protongamer/L3REL_RUCHE/pictures/Arduino_Schematic.png

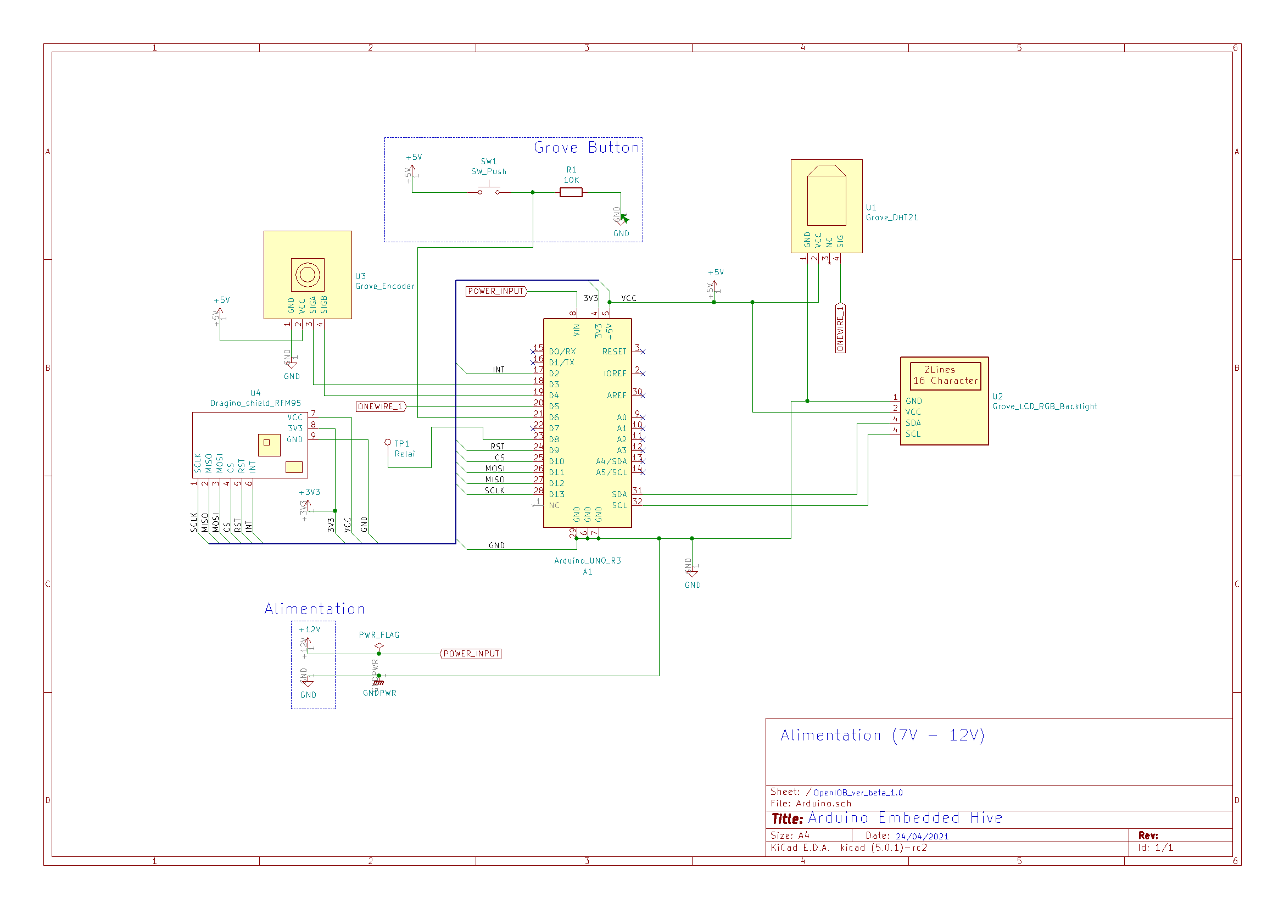
pictures/Arduino_Schematic.png
