protongamer/L3REL_RUCHE/pictures/bouton.png

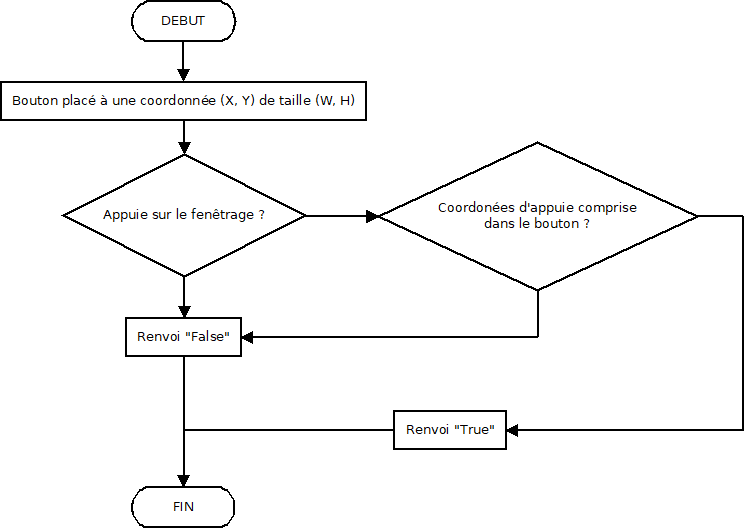
pictures/bouton.png
