protongamer/L3REL_RUCHE/pictures/IMG_20210322_151422.jpg

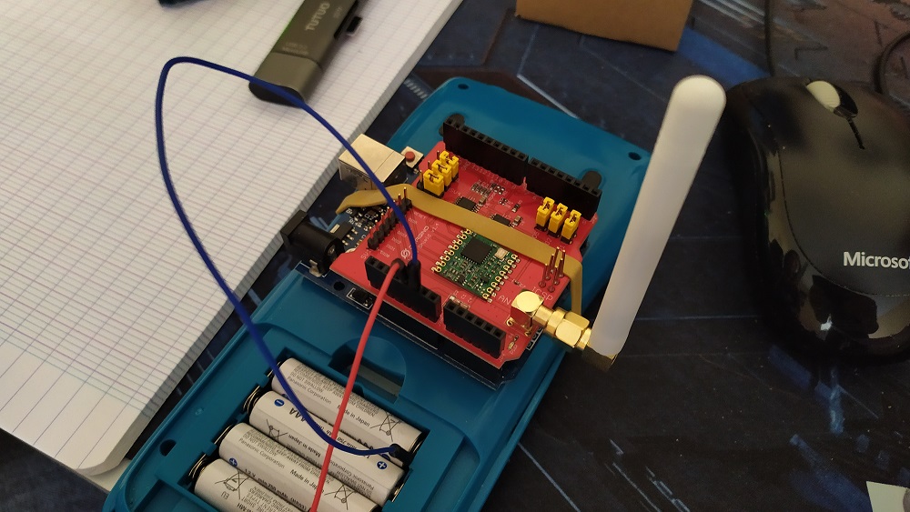
pictures/IMG_20210322_151422.jpg
