protongamer/L3REL_RUCHE/pictures/maps.png

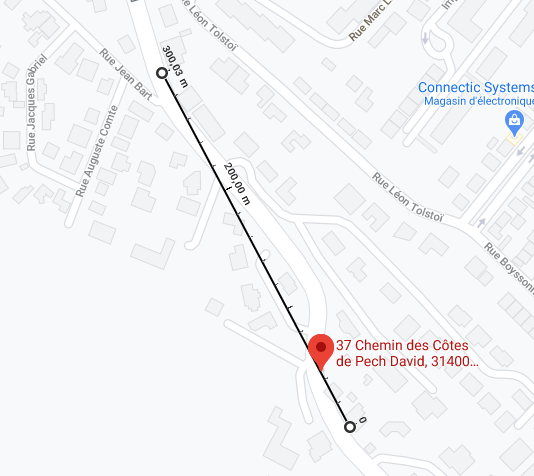
pictures/maps.png
