protongamer/L3REL_RUCHE/pictures/openiob_menus.png

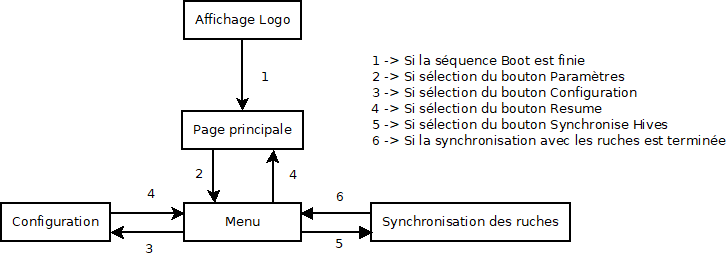
pictures/openiob_menus.png
