protongamer/L3REL_RUCHE/pictures/PSWD.png

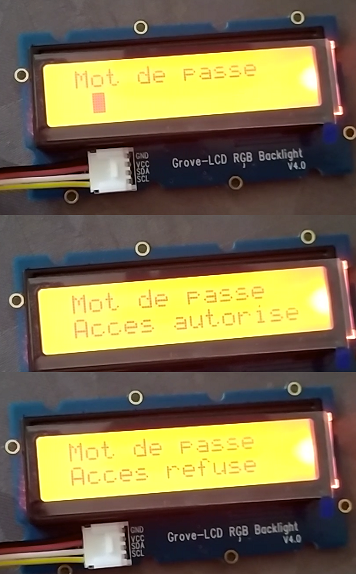
pictures/PSWD.png
