protongamer/L3REL_RUCHE/pictures/RPI_Schematic.png

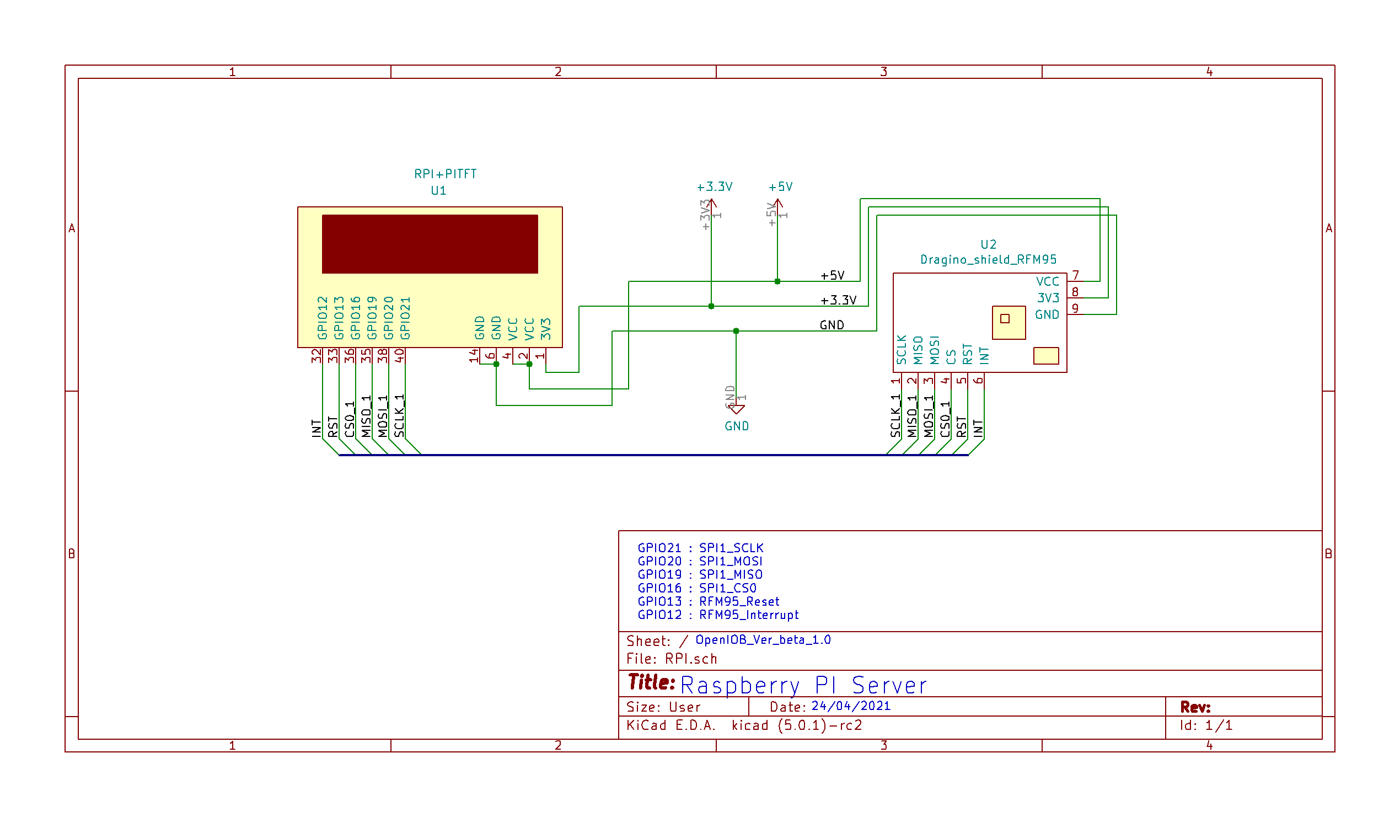
pictures/RPI_Schematic.png
