protongamer/L3REL_RUCHE/pictures/write_database.png

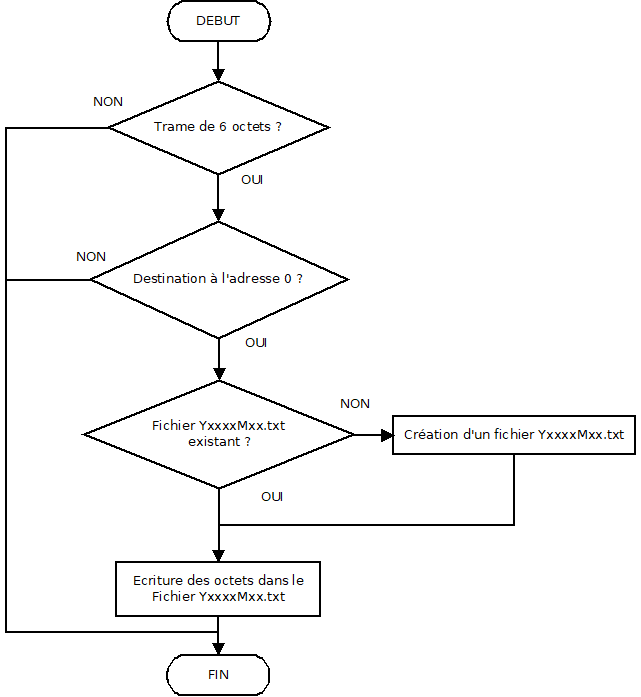
pictures/write_database.png
