protongamer/L3REL_RUCHE/Releves/Tram lu sur Arduino.png

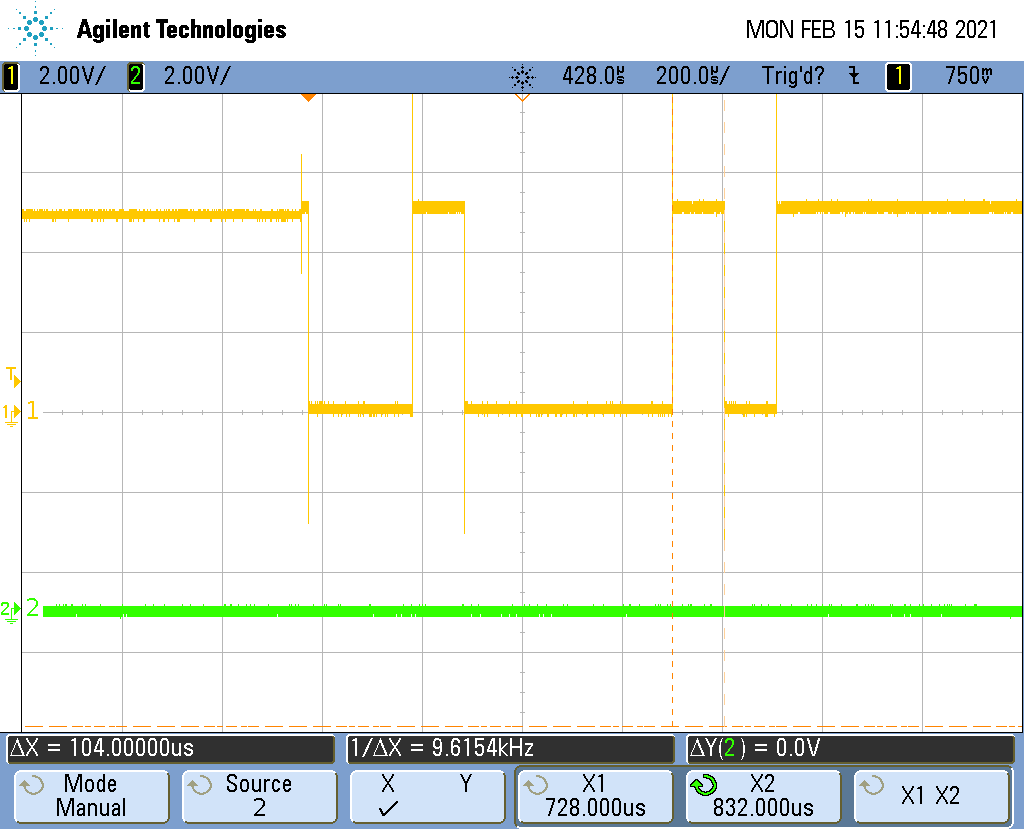
Releves/Tram lu sur Arduino.png
