protongamer/L3REL_RUCHE/Releves/Tram_transmission.PNG

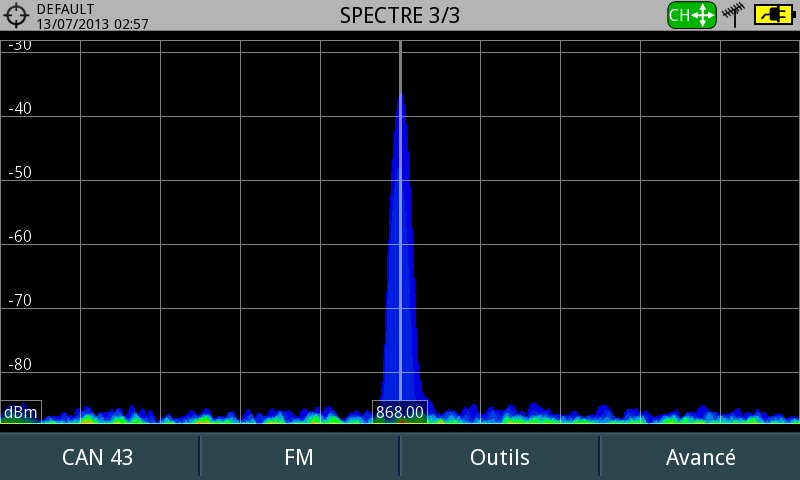
Releves/Tram_transmission.PNG
