protongamer/L3REL_RUCHE/Presentation_Projet.pdf

# Projet Ruche Connectée

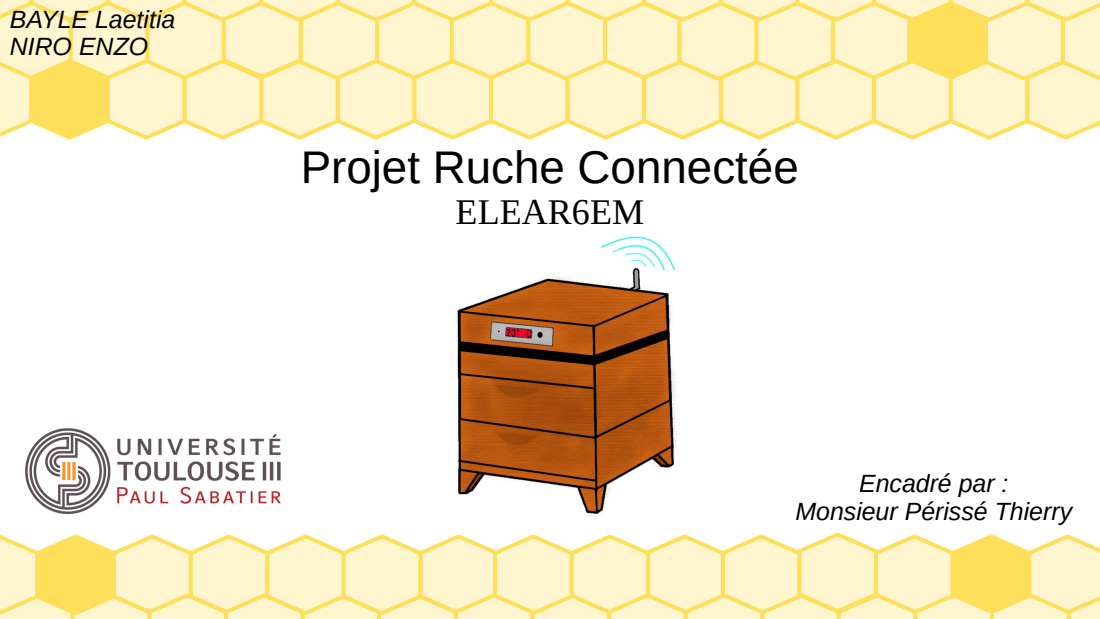
[picture p59: page 1]
ELEAR6EM; BAYLE Laetitia NIRO ENZO

Encadré par :
Monsieur Périssé Thierry

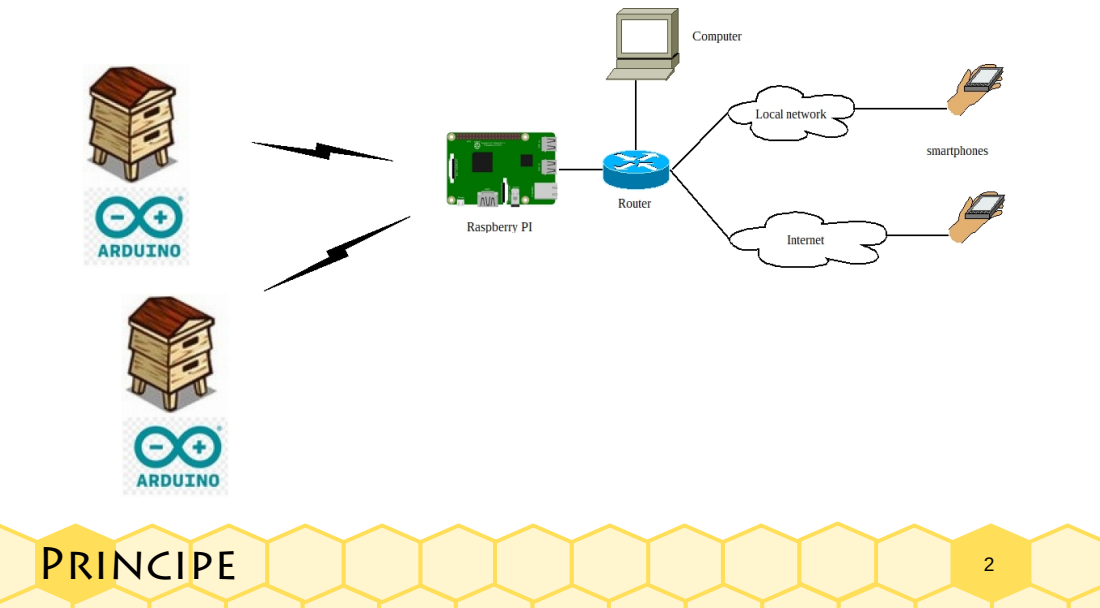
[picture p60: page 2]
Principe

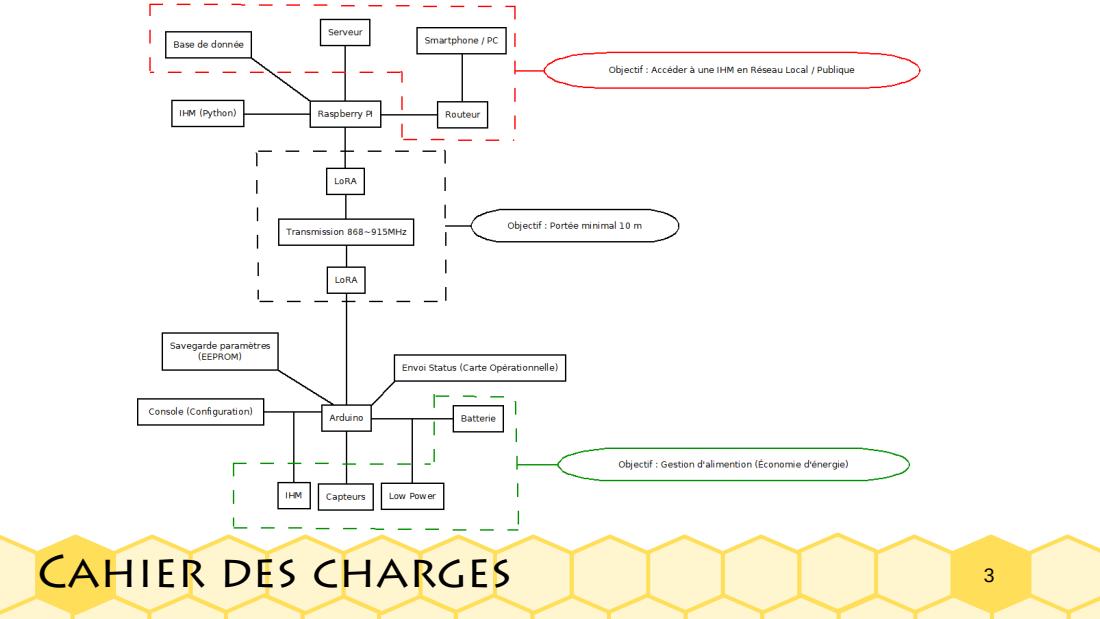
[picture p61: page 3]

Cahier des charges

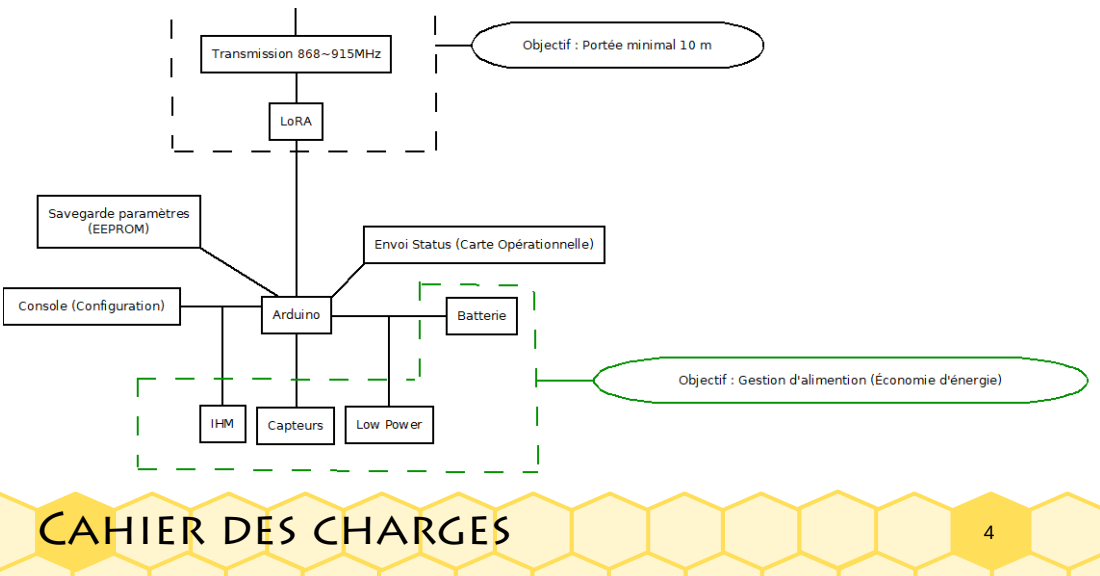
[picture p62: page 4]

Cahier des charges

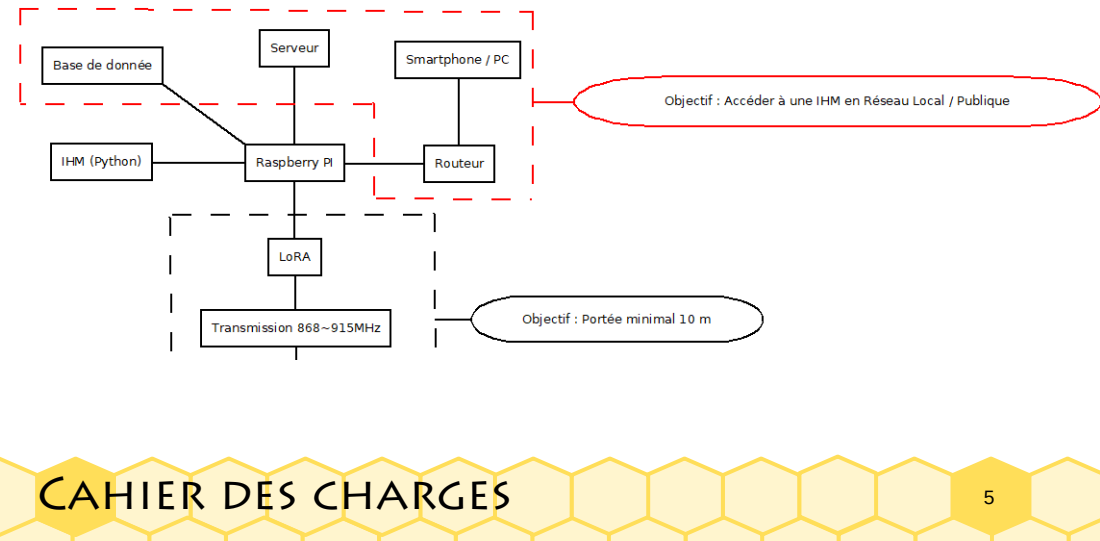
[picture p63: page 5]

Cahier des charges

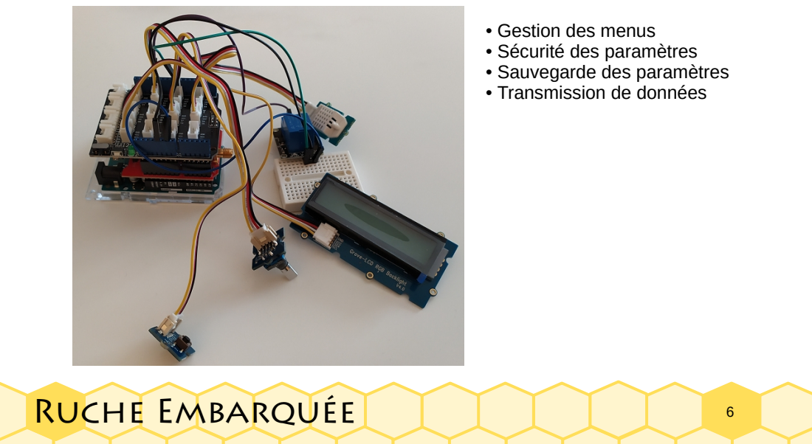
[picture p64: page 6]
Ruche Embarquée

• Gestion des menus
• Sécurité des paramètres
• Sauvegarde des paramètres
• Transmission de données

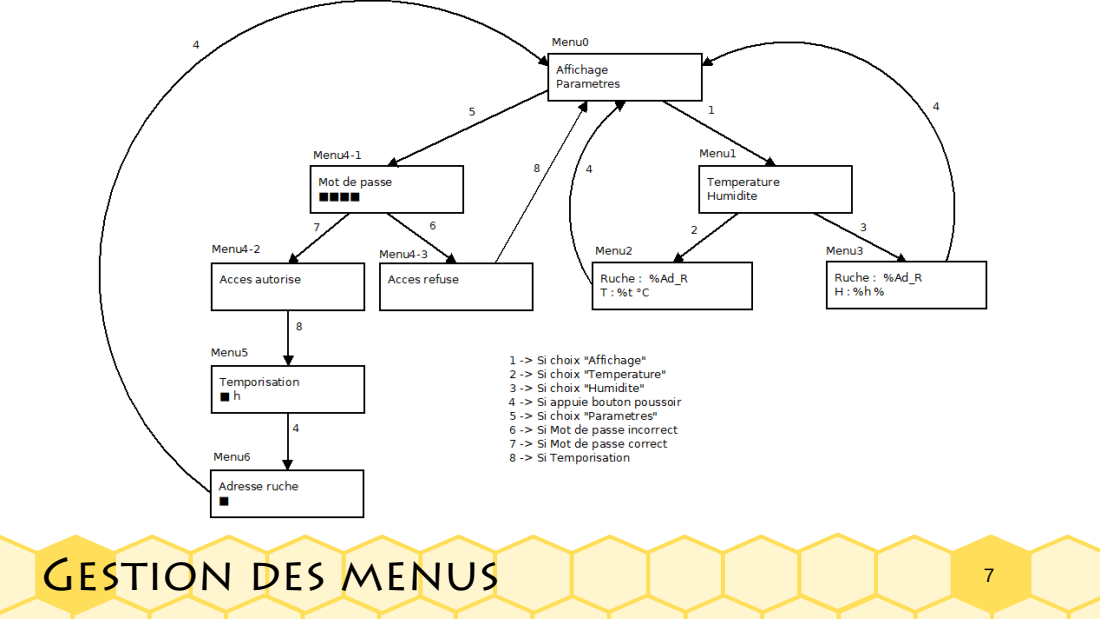
[picture p65: page 7]

Gestion des menus

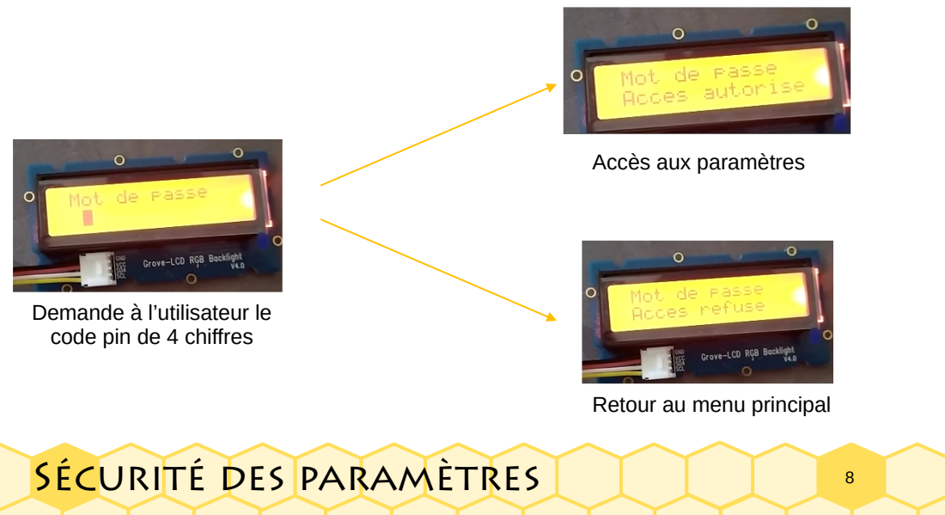
[picture p66: page 8]
Sécurité des paramètres

Accès aux paramètres

Demande à l’utilisateur le
code pin de 4 chiffres

Retour au menu principal

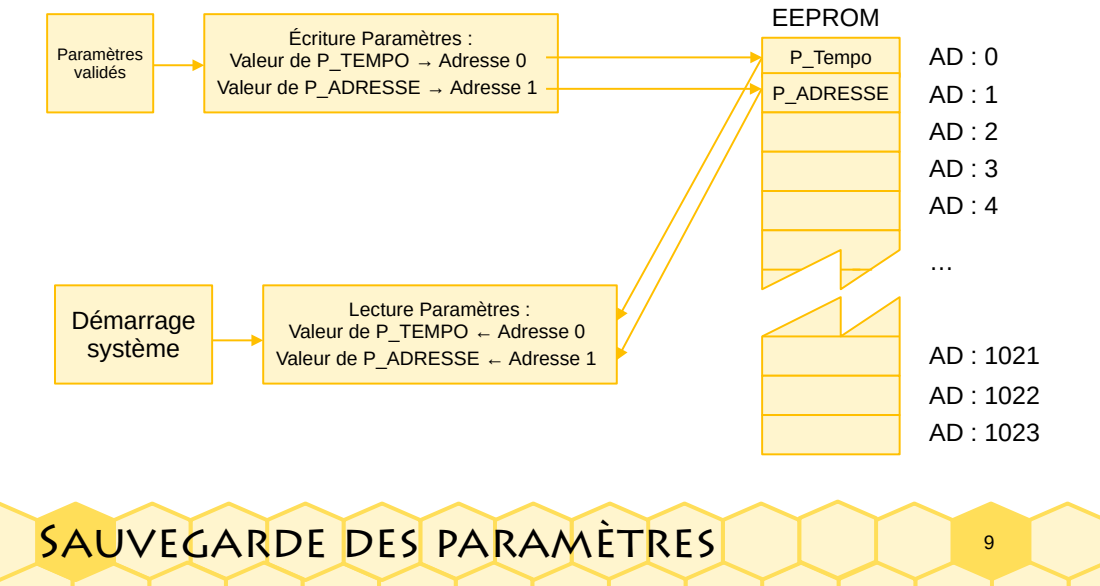
[picture p67: page 9]
Sauvegarde des paramètres; P_Tempo; P_ADRESSE; EEPROM; Paramètres validés; Démarrage système

Écriture Paramètres :
Valeur de P_TEMPO → Adresse 0
Valeur de P_ADRESSE → Adresse 1

Lecture Paramètres :
Valeur de P_TEMPO ← Adresse 0
Valeur de P_ADRESSE ← Adresse 1

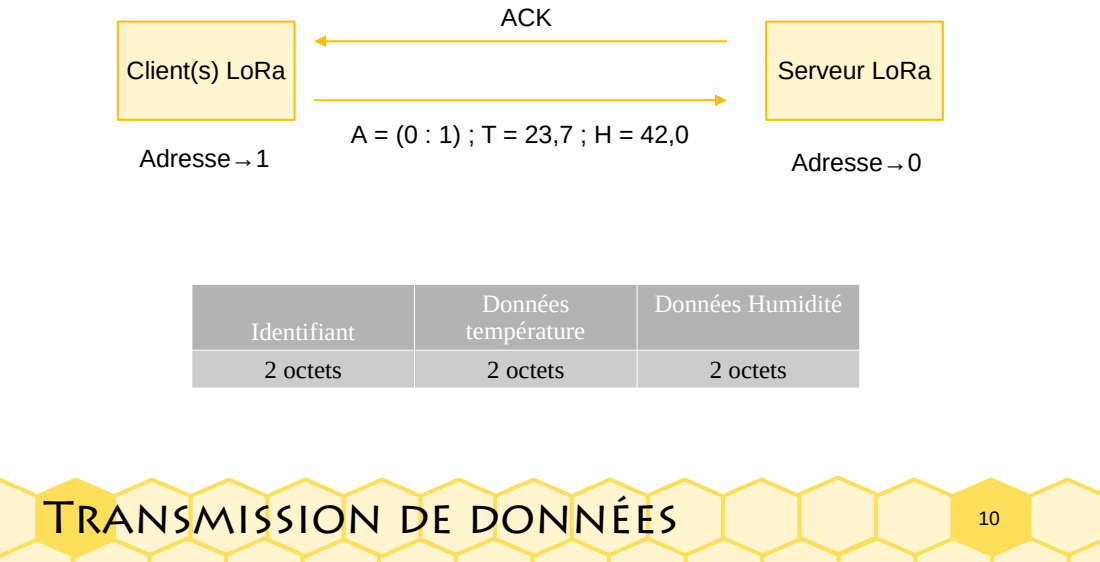
[picture p68: page 10]
Transmission de données; Client(s) LoRa; Serveur LoRa; Adresse→1; Adresse→0; ACK

Identifiant | Données température | Données Humidité

2 octets | 2 octets | 2 octets

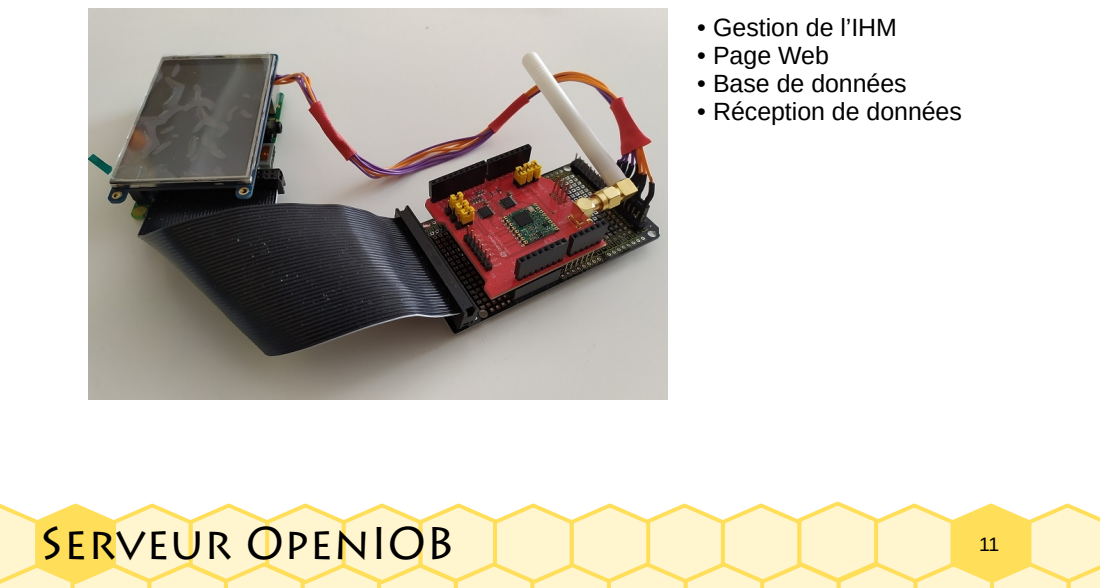
[picture p69: page 11]
Serveur OpenIOB

• Gestion de l’IHM
• Page Web
• Base de données
• Réception de données

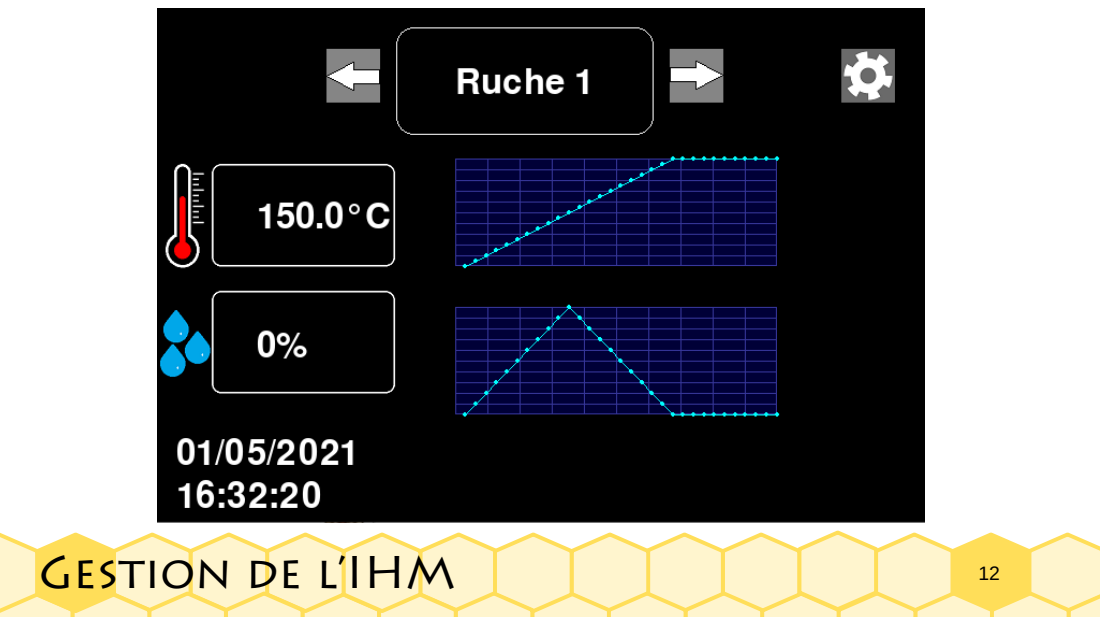
[picture p70: page 12]
Gestion de l’IHM

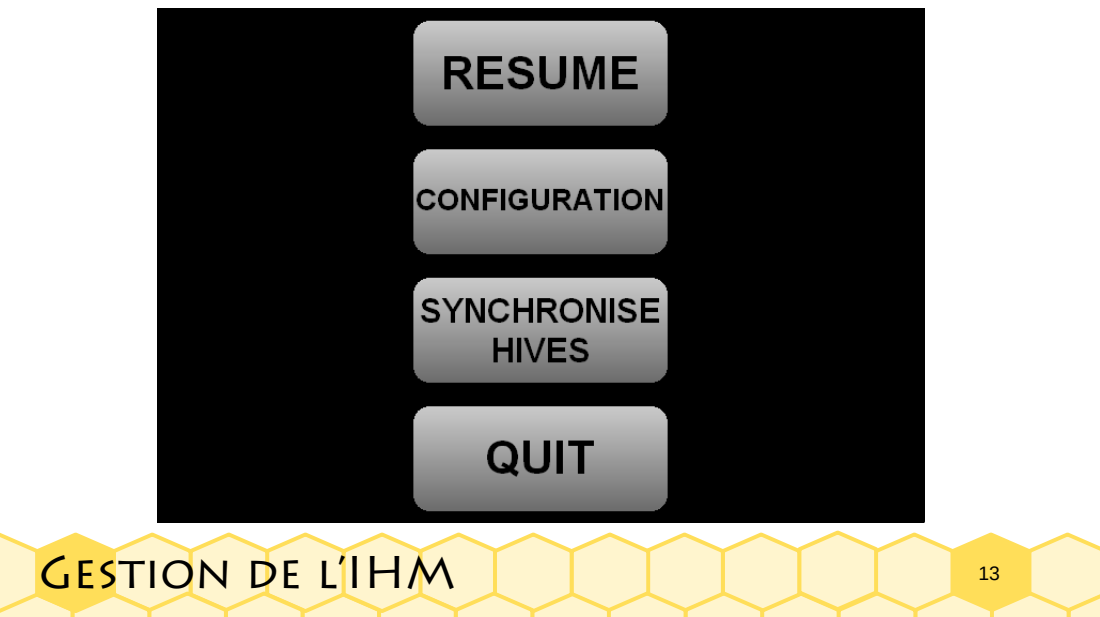
[picture p71: page 13]
Gestion de l’IHM

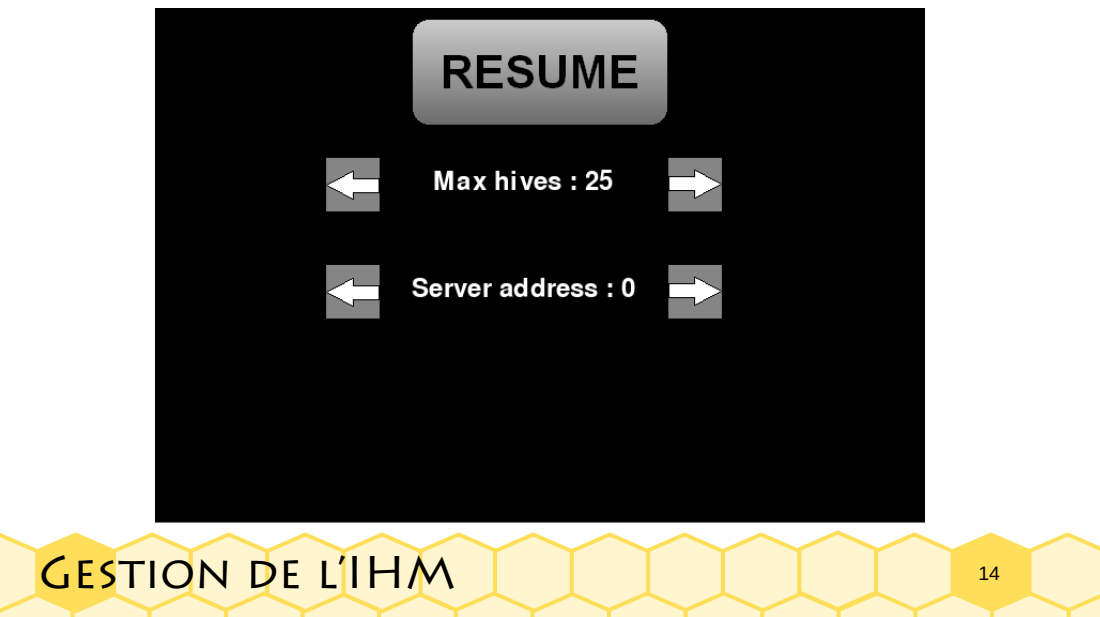
[picture p72: page 14]
Gestion de l’IHM

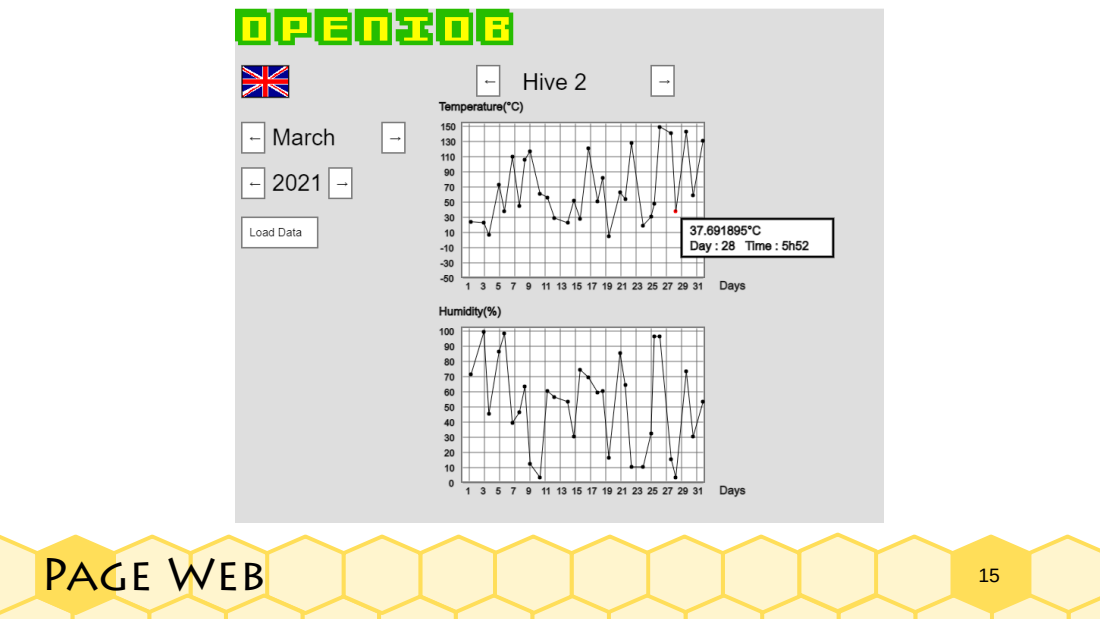
[picture p73: page 15]
Page Web

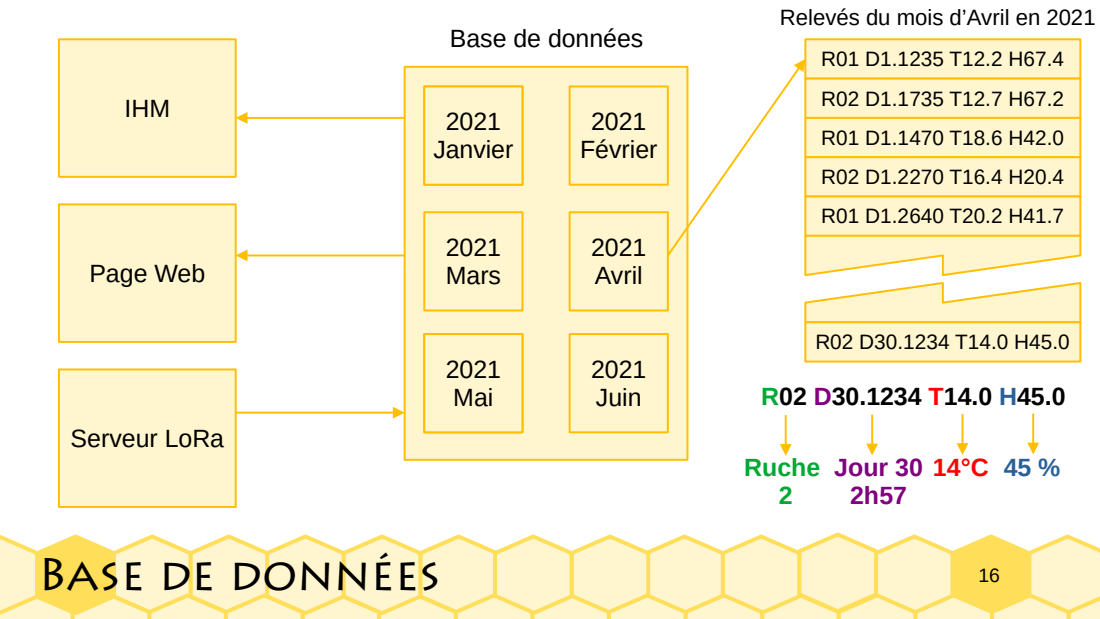
[picture p74: page 16]
Base de données; IHM; Page Web; Serveur LoRa; 2021 Janvier; 2021 Février; 2021 Avril; 2021 Mars; 2021 Mai; 2021 Juin; Ruche 2; Jour 30 2h57; Relevés du mois d’Avril en 2021

Base de données

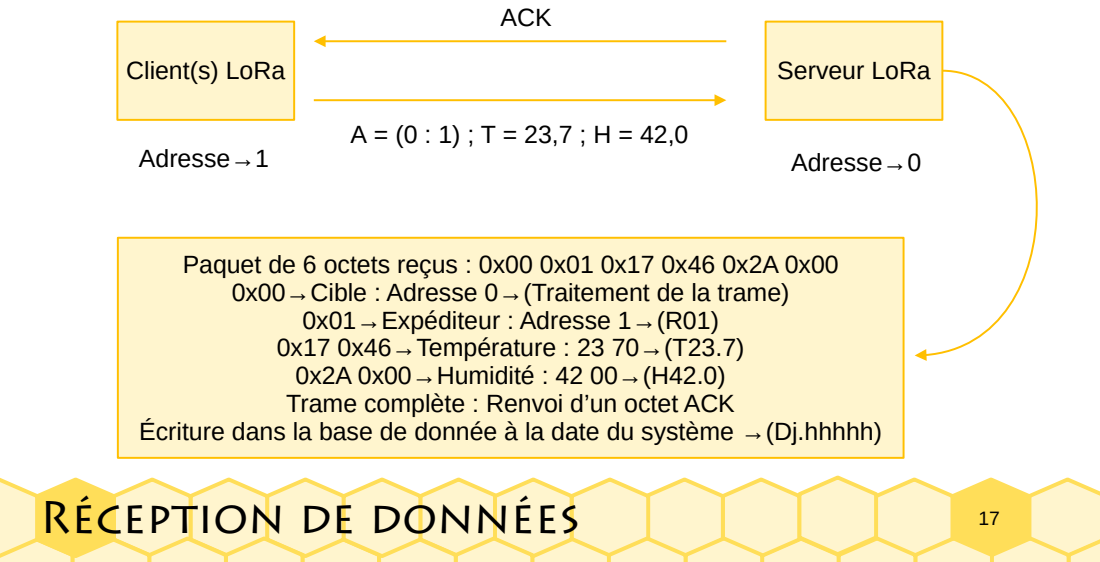
[picture p75: page 17]
Réception de données; Client(s) LoRa; Serveur LoRa; Adresse→1; Adresse→0; ACK

Paquet de 6 octets reçus : 0x00 0x01 0x17 0x46 0x2A 0x00
0x00→Cible : Adresse 0→(Traitement de la trame)
0x01→Expéditeur : Adresse 1→(R01)
0x17 0x46→Température : 23 70→(T23.7)
0x2A 0x00→Humidité : 42 00→(H42.0)
Trame complète : Renvoi d’un octet ACK

Écriture dans la base de donnée à la date du système →(Dj.hhhhh)

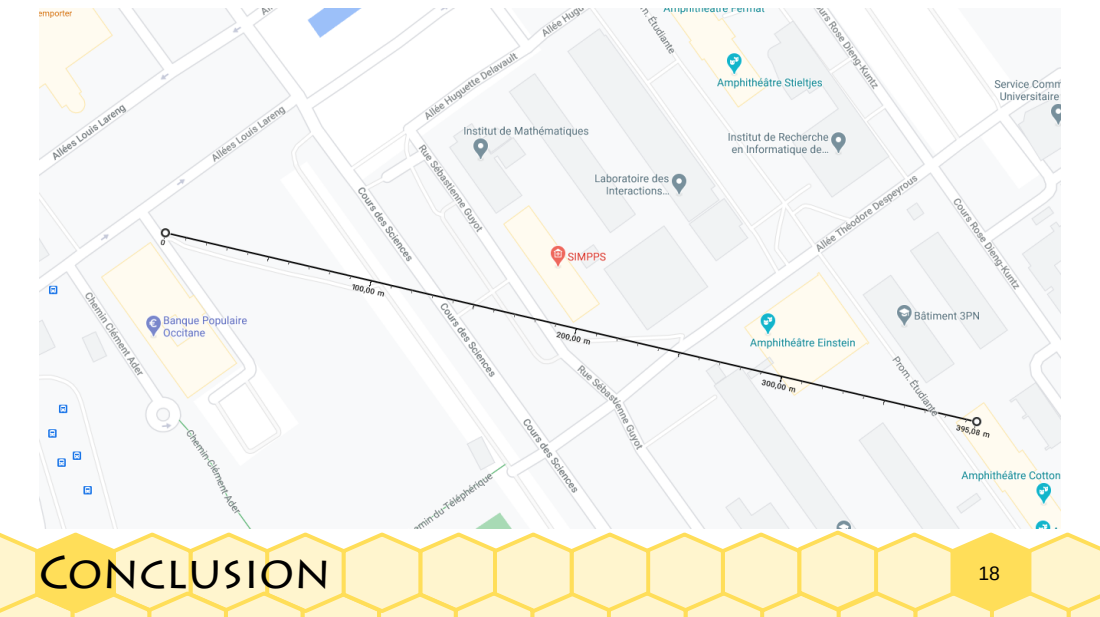
[picture p76: page 18]
Conclusion

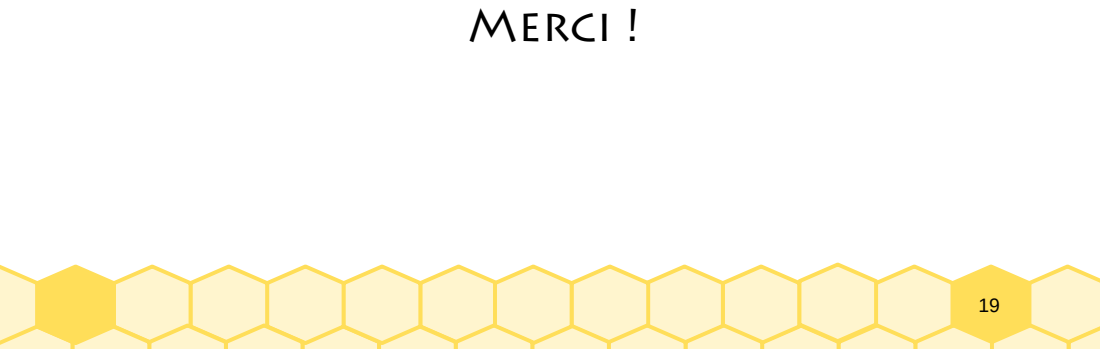
[picture p77: page 19]
Merci !
