protongamer/L3REL_RUCHE/Arduino/DHTtester/DHTtester.ino

#include "DHT.h"
#include <math.h>
#include <Wire.h>
#include "rgb_lcd.h"

rgb_lcd lcd;
 
const int colorR = 255;
const int colorG = 0;
const int colorB = 0;
 
#define DHTPIN 5    // what pin we're connected to

// Uncomment whatever type you're using!
//#define DHTTYPE DHT11   // DHT 11 
#define DHTTYPE DHT22  // DHT 22  (AM2302)
//#define DHTTYPE DHT21   // DHT 21 (AM2301)

// Connect pin 1 (on the left) of the sensor to +5V
// Connect pin 2 of the sensor to whatever your DHTPIN is
// Connect pin 4 (on the right) of the sensor to GROUND
// Connect a 10K resistor from pin 2 (data) to pin 1 (power) of the sensor

DHT dht(DHTPIN, DHTTYPE);

void setup() 
{

    Serial.begin(9600); 
    Serial.println("DHTxx test!");

    /*if using WIO link,must pull up the power pin.*/
    // pinMode(PIN_GROVE_POWER, OUTPUT);
    // digitalWrite(PIN_GROVE_POWER, 1);

    dht.begin();

    // Défini le nombre de colonne et de ligne
    lcd.begin(16, 2);
 
    lcd.setRGB(colorR, colorG, colorB);
}

void loop() 
{
    // Reading temperature or humidity takes about 250 milliseconds!
    // Sensor readings may also be up to 2 seconds 'old' (its a very slow sensor)
    float h = dht.readHumidity();
    float t = dht.readTemperature();

    // check if returns are valid, if they are NaN (not a number) then something went wrong!
    if (isnan(t) || isnan(h)) 
    {
        Serial.println("Failed to read from DHT");
    } 
    else 
    {
        Serial.print("Humidity: "); 
        Serial.print(h);
        Serial.print(" %\t");
        Serial.print("Temperature: "); 
        Serial.print(t);
        Serial.println(" *C");

            // mettre le curseur en colonne 0 et ligne 1
    lcd.setCursor(0, 1);
    // On affiche la température
    lcd.print(t);
    lcd.write(223);
    lcd.print("C");
     
            // mettre le curseur en colonne 0 et ligne 0
    lcd.setCursor(0, 0);
     // On affiche l'humidite
    lcd.print(h);
    lcd.print("%");
    
    delay(1000);
    }
    delay(1000);
}
