protongamer/L3REL_RUCHE/(commit log)

2021-02-15 fiche technique carte de communication LoRa
2021-02-16 Ajout de la doc du module ARM-N8-LRW
2021-02-16 Ajout de relevés intéressants sur les modules Lora
    Communication
    Low-Power(ou Deep Sleep pour les plus familier)
    Commandes ATs
2021-02-22 Edit du 22/02/2021 18:54
    Proposition d'abandonner le module ARM-N8-LW (obsolète), pour passer sur un autre, (RFM95 ?)
2021-02-23 Ajout d'un code d'exemple en python pour la RPI
    Utilise la librairie pygame pour la core graphique
2021-03-06 Update Python code and add stuff
    -Alpha v0.3
    -Add boot logo
    -Display temperatures and humidity per hive(Max 5 at this moment)
    -Method to exit app(for dev)
    -Method to read text file(bootPrint.md) → useful to read database
    -Add current date & time
2021-03-09 Added Arduino stuff
2021-03-22 Added LoRa source code for Arduino
2021-03-29 Python program update
    Added functionnal graph
    [parameters.cfg]
2021-04-10 Python app updated
    [parameters.cfg]
2021-04-16 Arduino update
2021-04-16 Python and Webserver updated
    [parameters.cfg]
